batkay/lightstick_v4/lightstick_v4/lightstick_v4.kicad_pcb

## KiCad design lightstick_v4/lightstick_v4.kicad_pcb (2026-01-29)

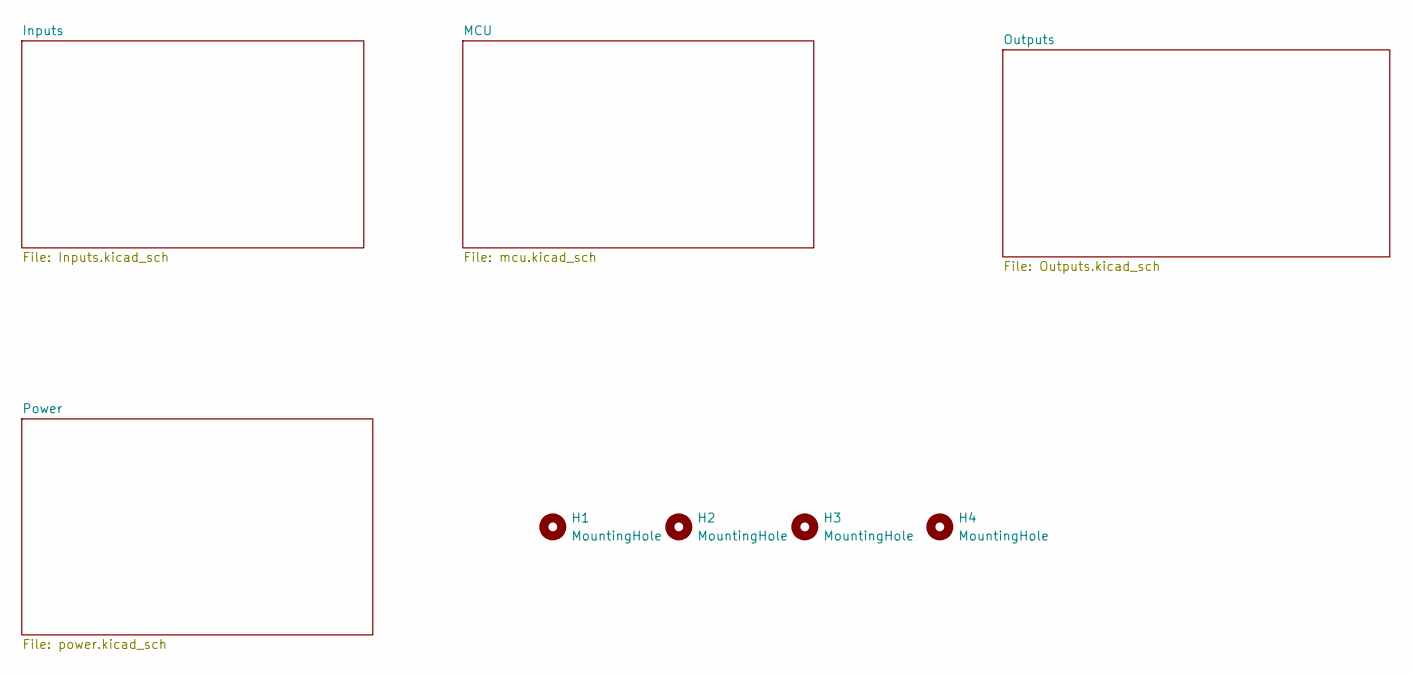
[picture p1: schematic lightstick_v4.kicad_sch]

Parts:
H1, H2, H3, H4: MountingHole; MountingHole_2.1mm

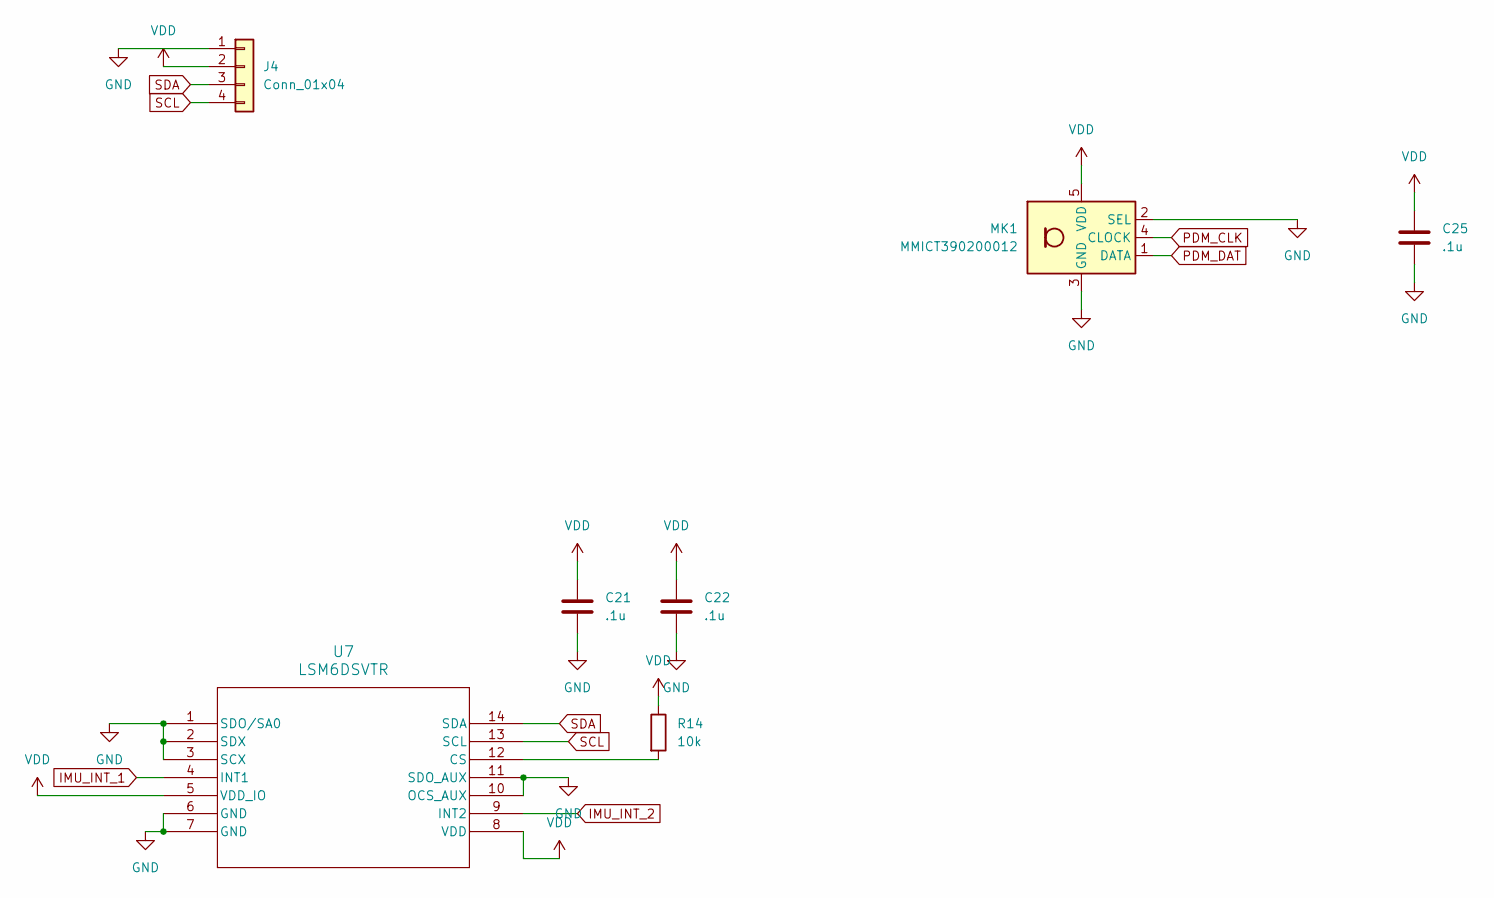
[picture p2: schematic Inputs.kicad_sch]

Parts:
C21, C22, C25: .1u; C_0402_1005Metric; MPN C77020; LCSC PN C77020
J4: Conn_01x04; JST_SH_BM04B-SRSS-TB_1x04-1MP_P1.00mm_Vertical; Part Number JST BM04B-SRSS-TB(LF)(SN); LCSC PN C495539
MK1: MMICT390200012; Knowles_LGA-5_3.5x2.65mm; Part Number MMICT390200012; LCSC PN C3171752
R14: 10k; R_0603_1608Metric; MPN C98220; LCSC PN C98220
U7: LSM6DSVTR; LGA14-L_2P59X3P1X0P5_STM; MPN C17496470; LCSC PN C17496470

Connections:
GND: C21.2, C22.2, C25.2, J4.1, MK1.2 (SEL), MK1.3 (GND), U7.1 (SDO/SA0), U7.2 (SDX), U7.3 (SCX), U7.6 (GND), U7.7 (GND), U7.10 (OCS_AUX), U7.11 (SDO_AUX); also elsewhere on the board
IMU_INT_1: U7.4 (INT1); also elsewhere on the board
IMU_INT_2: U7.9 (INT2); also elsewhere on the board
unnamed: R14.2, U7.12 (CS)
PDM_CLK: MK1.4 (CLOCK); also elsewhere on the board
PDM_DAT: MK1.1 (DATA); also elsewhere on the board
SCL: J4.4, U7.13 (SCL); also elsewhere on the board
SDA: J4.3, U7.14 (SDA); also elsewhere on the board
VDD: C21.1, C22.1, C25.1, J4.2, MK1.5 (VDD), R14.1, U7.5 (VDD_IO), U7.8 (VDD); also elsewhere on the board

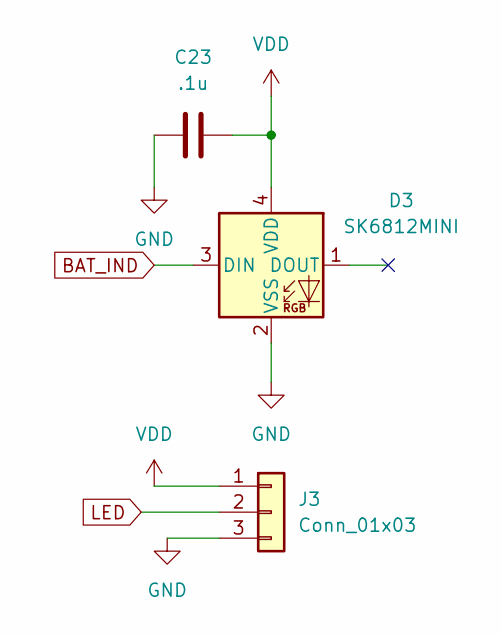
[picture p3: schematic Outputs.kicad_sch]

Parts:
C23: .1u; C_0402_1005Metric; MPN C77020; LCSC PN C77020
D3: SK6812MINI; LED_SK6812MINI_PLCC4_3.5x3.5mm_P1.75mm; MPN C7423117; LCSC PN C7423117
J3: Conn_01x03; PinHeader_1x03_P2.54mm_Horizontal; MPN C92159; LCSC PN C92159

Connections:
BAT_IND: D3.3 (DIN); also elsewhere on the board
GND: C23.1, D3.2 (VSS), J3.3; also elsewhere on the board
LED: J3.2; also elsewhere on the board
VDD: C23.2, D3.4 (VDD), J3.1; also elsewhere on the board

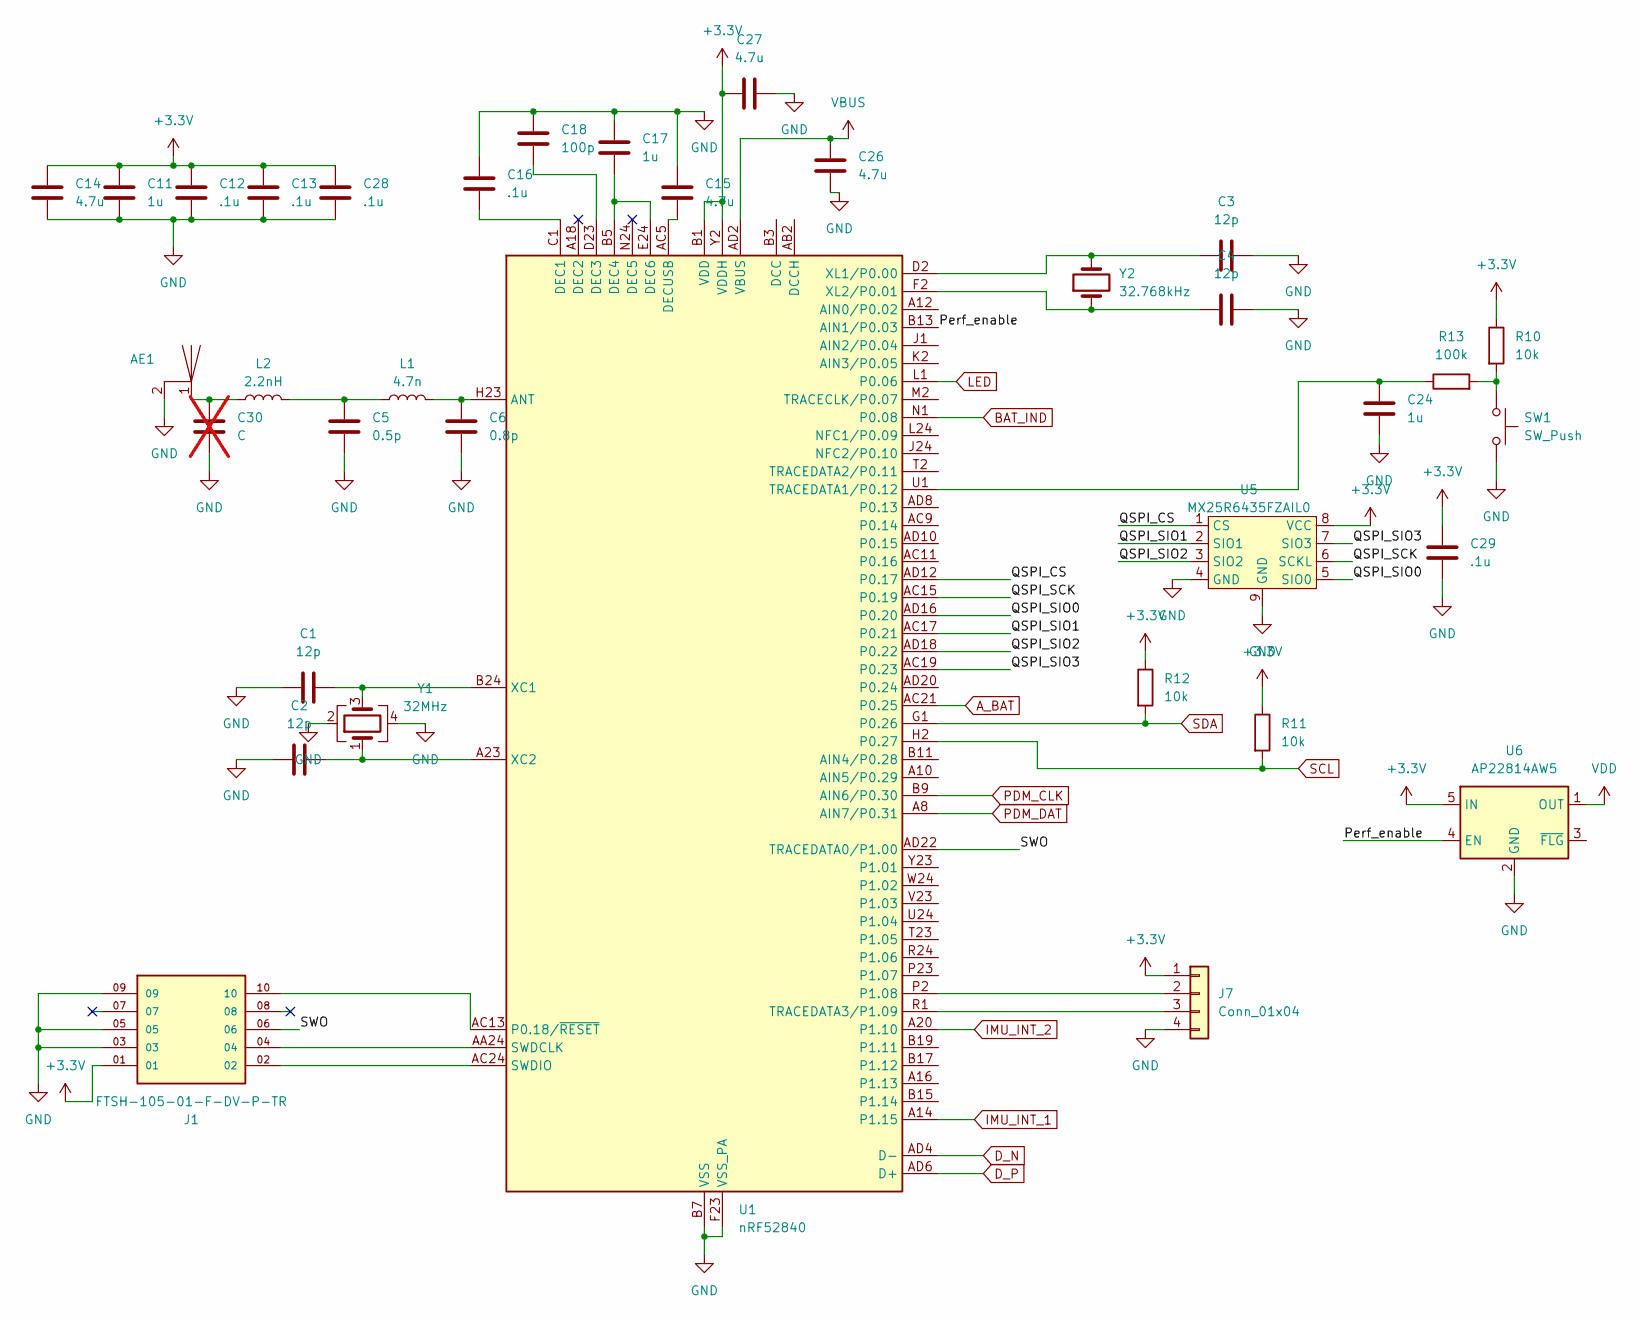
[picture p4: schematic mcu.kicad_sch]

Parts:
AE1: Trace Antenna
C1, C2, C3, C4: 12p; C_0402_1005Metric; MPN C76948; LCSC PN C76948
C5: 0.5p; C_0402_1005Metric; MPN C76912; LCSC PN C76912
C6: 0.8p; C_0402_1005Metric; MPN C88902; LCSC PN C88902
C11, C17, C24: 1u; C_0603_1608Metric; MPN C85862; LCSC PN C85862
C12, C13, C16, C28, C29: .1u; C_0402_1005Metric; MPN C77020; LCSC PN C77020
C14, C15, C26, C27: 4.7u; C_0603_1608Metric; MPN C19666; LCSC PN C19666
C18: 100p; C_0402_1005Metric; MPN C26409; LCSC PN C26409
C30: C; C_0402_1005Metric; not fitted
J1: FTSH-105-01-F-DV-P-TR; SAMTEC_FTSH-105-01-F-DV-P-TR; PARTREV R; LCSC PN C2932107
J7: Conn_01x04; PinHeader_1x04_P2.54mm_Vertical; MPN C52016392; LCSC PN C52016392
L1: 4.7n; L_0402_1005Metric; MPN C412337; LCSC PN C412337
L2: 2.2nH; C_0402_1005Metric; MPN C162540; LCSC PN C162540
R10, R11, R12: 10k; R_0603_1608Metric; MPN C98220; LCSC PN C98220
R13: 100k; R_0603_1608Metric; MPN C14675; LCSC PN C14675
SW1: SW_Push; Hotswap_Kailh_MX_Top; MPN C41430893; LCSC PN C41430893
U1: nRF52840; Nordic_AQFN-73-1EP_7x7mm_P0.5mm; Part Number NRF52840-QIAA-R; LCSC PN C190794
U5: MX25R6435FZAIL0; WSON-8-1EP_4x4mm_P0.8mm_EP1.98x3mm; Part Number MX25R6435FZAIL0; LCSC PN C2802847
U6: AP22814AW5; SOT-23-5; MPN C2680321; LCSC PN C2680321
Y1: 32MHz; Crystal_SMD_2016-4Pin_2.0x1.6mm; Part Number Murata XRCGB32M000F2P10R0; LCSC PN C341819
Y2: 32.768kHz; Crystal_SMD_3215-2Pin_3.2x1.5mm; Part Number Seiko SC-32S32.768kHz20PPM9pF; LCSC PN C97605

Connections:
+3.3V: C11.1, C12.1, C13.1, C14.1, C27.1, C28.1, C29.1, J1.01, J7.1, R10.1, R11.1, R12.1, U1.A22 (VDD), U1.AD14 (VDD), U1.AD23 (VDD), U1.B1 (VDD), U1.W1 (VDD), U1.Y2 (VDDH), U5.8 (VCC), U6.5 (IN); also elsewhere on the board
/MCU/Perf_enable: U1.B13 (AIN1/P0.03), U6.4 (EN)
/MCU/QSPI_CS: U1.AD12 (P0.17), U5.1 (CS)
/MCU/QSPI_SCK: U1.AC15 (P0.19), U5.6 (SCKL)
/MCU/QSPI_SIO0: U1.AD16 (P0.20), U5.5 (SIO0)
/MCU/QSPI_SIO1: U1.AC17 (P0.21), U5.2 (SIO1)
/MCU/QSPI_SIO2: U1.AD18 (P0.22), U5.3 (SIO2)
/MCU/QSPI_SIO3: U1.AC19 (P0.23), U5.7 (SIO3)
/MCU/SWO: J1.06, U1.AD22 (TRACEDATA0/P1.00)
A_BAT: U1.AC21 (P0.25); also elsewhere on the board
BAT_IND: U1.N1 (P0.08); also elsewhere on the board
D_N: U1.AD4 (D-); also elsewhere on the board
D_P: U1.AD6 (D+); also elsewhere on the board
GND: AE1.2, C1.1, C2.1, C3.2, C4.2, C5.2, C6.2, C11.2, C12.2, C13.2, C14.2, C15.2, C16.1, C17.1, C18.1, C24.2, C26.2, C27.2, C28.2, C29.2, C30.2, J1.03, J1.05, J1.09, J7.4, SW1.2, U1.B7 (VSS), U1.EP (VSS), U1.F23 (VSS_PA), U5.4 (GND), U5.9 (GND), U6.2 (GND), Y1.2, Y1.4; also elsewhere on the board
IMU_INT_1: U1.A14 (P1.15); also elsewhere on the board
IMU_INT_2: U1.A20 (P1.10); also elsewhere on the board
LED: U1.L1 (P0.06); also elsewhere on the board
unnamed: AE1.1, C30.1, L2.1
unnamed: C5.1, L1.1, L2.2
unnamed: J7.2, U1.P2 (P1.08)
unnamed: J7.3, U1.R1 (TRACEDATA3/P1.09)
unnamed: R10.2, R13.2, SW1.1
unnamed: C6.1, L1.2, U1.H23 (ANT)
unnamed: C16.2, U1.C1 (DEC1)
unnamed: C18.2, U1.D23 (DEC3)
unnamed: C17.2, U1.B5 (DEC4), U1.E24 (DEC6)
unnamed: C15.1, U1.AC5 (DECUSB)
unnamed: J1.10, U1.AC13 (P0.18/~RESET)
unnamed: J1.04, U1.AA24 (SWDCLK)
unnamed: J1.02, U1.AC24 (SWDIO)
unnamed: C24.1, R13.1, U1.U1 (TRACEDATA1/P0.12)
unnamed: C1.2, U1.B24 (XC1), Y1.3
unnamed: C2.2, U1.A23 (XC2), Y1.1
unnamed: C3.1, U1.D2 (XL1/P0.00), Y2.2
unnamed: C4.1, U1.F2 (XL2/P0.01), Y2.1
PDM_CLK: U1.B9 (AIN6/P0.30); also elsewhere on the board
PDM_DAT: U1.A8 (AIN7/P0.31); also elsewhere on the board
SCL: R11.2, U1.H2 (P0.27); also elsewhere on the board
SDA: R12.2, U1.G1 (P0.26); also elsewhere on the board
VBUS: C26.1, U1.AD2 (VBUS); also elsewhere on the board
VDD: U6.1 (OUT); also elsewhere on the board

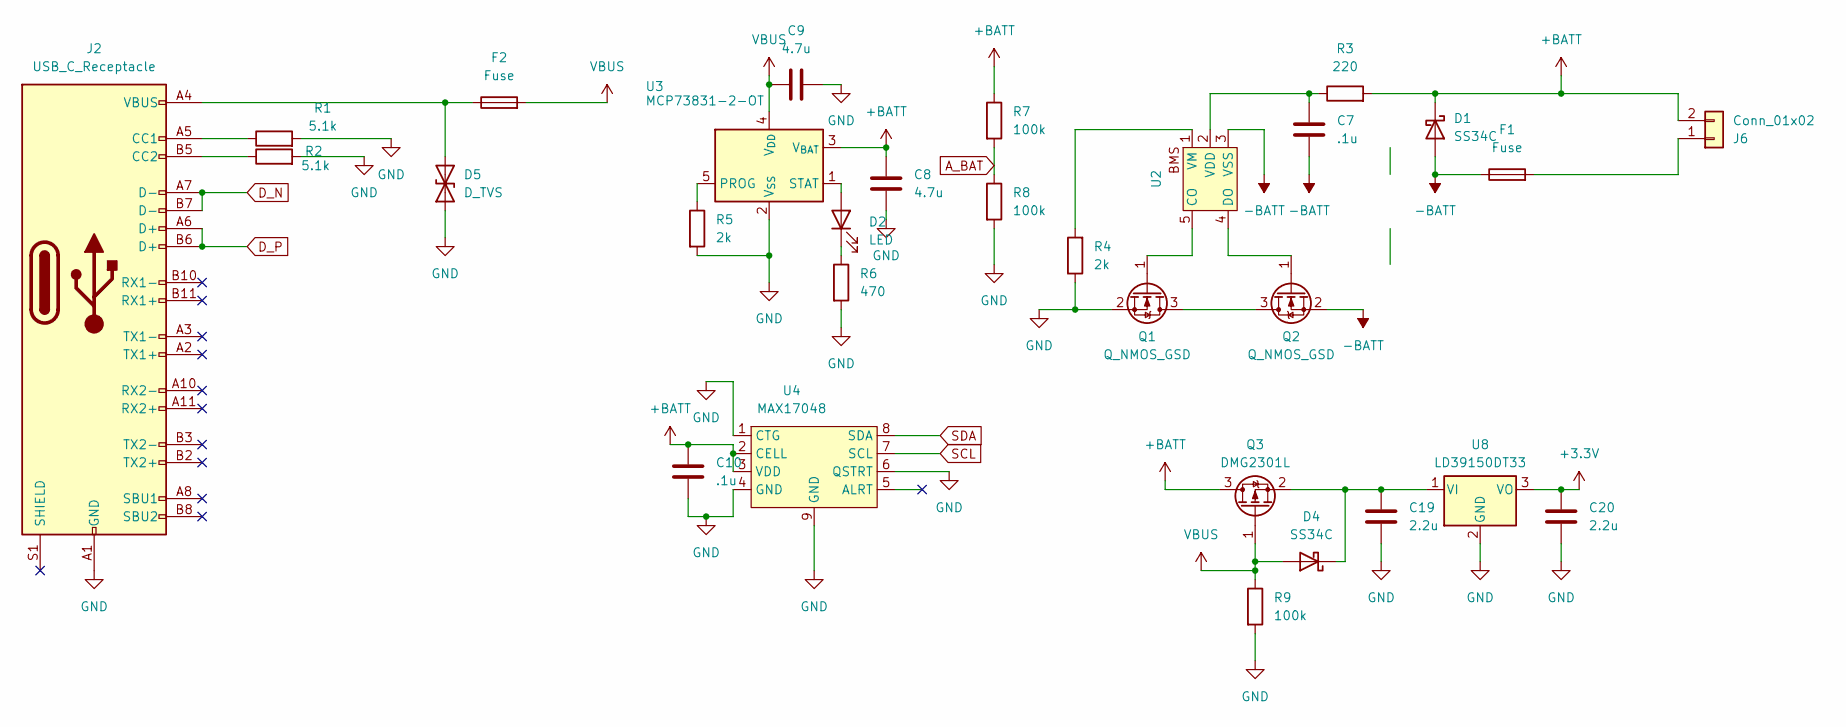
[picture p5: schematic power.kicad_sch]

Parts:
C7, C10: .1u; C_0402_1005Metric; MPN C77020; LCSC PN C77020
C8, C9: 4.7u; C_0603_1608Metric; MPN C19666; LCSC PN C19666
C19, C20: 2.2u; C_0603_1608Metric; MPN C415535; LCSC PN C415535
D1, D4: SS34C; D_SMC; MPN C13763; LCSC PN C13763
D2: LED; LED_0805_2012Metric; MPN C2293; LCSC PN C2293
D5: D_TVS; D_0402_1005Metric; Part Number TPD1E10B06DPYR; LCSC PN C48260
F1: Fuse; Fuse_1210_3225Metric; Part Number Shenzhen JDT Fuse ASMD1210-075; LCSC PN C20806
F2: Fuse; Fuse_1210_3225Metric; Part Number TECHFUSE SL1210350; LCSC PN C20806
J2: USB_C_Receptacle; USB_C_Receptacle_GCT_USB4105-xx-A_16P_TopMnt_Horizontal; Part Number MC-107D; LCSC PN C2874568
J6: Conn_01x02; JST_PH_B2B-PH-K_1x02_P2.00mm_Vertical; MPN C131337; LCSC PN C131337
Q1, Q2: Q_NMOS_GSD; TSOT-23; Part Number DMG3414U-7; LCSC PN C260927
Q3: DMG2301L; SOT-23; MPN C102619; LCSC PN C102619
R1, R2: 5.1k; R_0603_1608Metric; MPN C122969; LCSC PN C122969
R3: 220; R_0603_1608Metric; MPN C107696; LCSC PN C107696
R4, R5: 2k; R_0603_1608Metric; MPN C105576; LCSC PN C105576
R6: 470; R_0603_1608Metric; MPN C114669; LCSC PN C114669
R7, R8: 100k; R_0603_1608Metric; MPN C19666; LCSC PN C14675
R9: 100k; R_0603_1608Metric; MPN C14675; LCSC PN C14675
U2: SOT-23-5; Part Number S-8211CAZ-M5T1G; LCSC PN C5881307
U3: MCP73831-2-OT; SOT-23-5; Part Number MCP73831T-2ACI/OT; LCSC PN C424093
U4: MAX17048; TDFN-8-1EP_2x2mm_P0.5mm_EP0.8x1.2mm; MPN C2682616; LCSC PN C2682616
U8: LD39150DT33; TO-252-3_TabPin2; MPN C155559; LCSC PN C155559

Connections:
+3.3V: C20.1, U8.3 (VO); also elsewhere on the board
+BATT: C8.1, C10.1, D1.1 (K), J6.2, Q3.3 (D), R3.2, R7.1, U3.3 (V_{BAT}), U4.2 (CELL), U4.3 (VDD)
-BATT: C7.2, D1.2 (A), F1.1, Q2.2 (S), U2.3 (VSS)
A_BAT: R7.2, R8.1; also elsewhere on the board
D_N: J2.A7 (D-), J2.B7 (D-); also elsewhere on the board
D_P: J2.A6 (D+), J2.B6 (D+); also elsewhere on the board
GND: C8.2, C9.2, C10.2, C19.2, C20.2, D5.1 (A1), J2.A1 (GND), J2.A12 (GND), J2.B1 (GND), J2.B12 (GND), Q1.2 (S), R1.2, R2.2, R4.1, R5.2, R6.2, R8.2, R9.2, U3.2 (V_{SS}), U4.1 (CTG), U4.4 (GND), U4.6 (QSTRT), U4.9 (GND), U8.2 (GND); also elsewhere on the board
unnamed: D2.2 (A), U3.1 (STAT)
unnamed: D2.1 (K), R6.1
unnamed: C19.1, D4.1 (K), Q3.2 (S), U8.1 (VI)
unnamed: D5.2 (A2), F2.1, J2.A4 (VBUS), J2.A9 (VBUS), J2.B4 (VBUS), J2.B9 (VBUS)
unnamed: J2.A5 (CC1), R1.1
unnamed: J2.B5 (CC2), R2.1
unnamed: F1.2, J6.1
unnamed: Q1.3 (D), Q2.3 (D)
unnamed: Q1.1 (G), U2.5 (CO)
unnamed: Q2.1 (G), U2.4 (DO)
unnamed: C7.1, R3.1, U2.2 (VDD)
unnamed: R4.2, U2.1 (VM)
unnamed: R5.1, U3.5 (PROG)
SCL: U4.7 (SCL); also elsewhere on the board
SDA: U4.8 (SDA); also elsewhere on the board
VBUS: C9.1, D4.2 (A), F2.2, Q3.1 (G), R9.1, U3.4 (V_{DD}); also elsewhere on the board

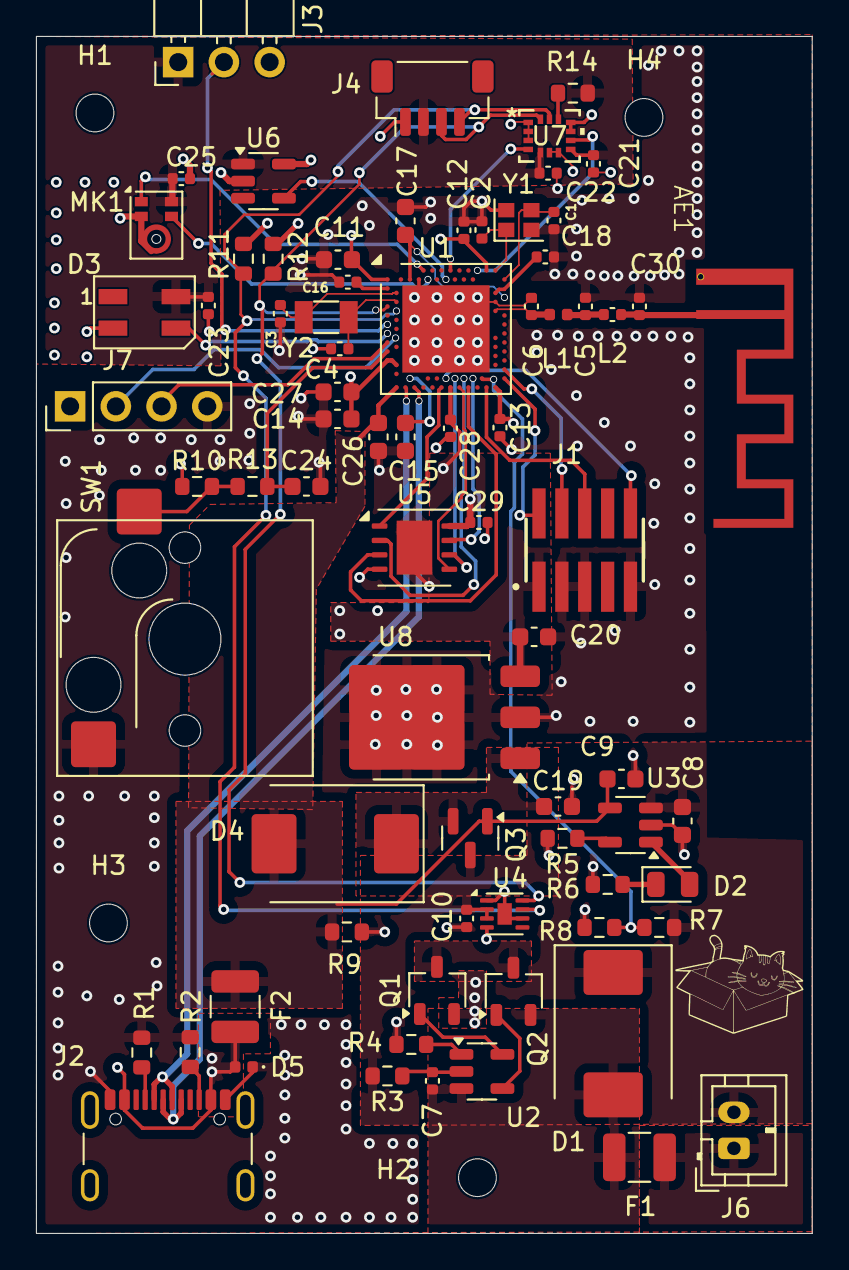
[picture p6: board lightstick_v4.kicad_pcb from above]

Board: 4 copper layers, 43.1 x 66.5 mm, 79 parts (0 on the bottom side), 57 nets.
